Warren-SJ/Solar_Tracker/PCB/Top.png

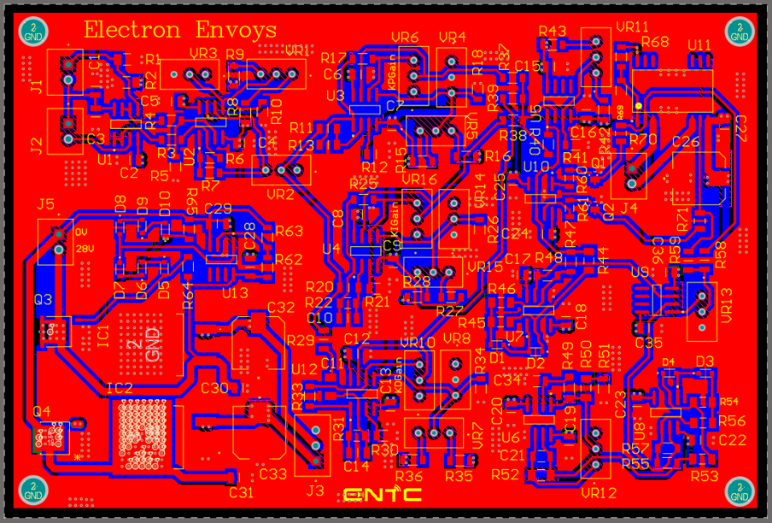
PCB/Top.png
