Warren-SJ/Solar_Tracker/PCB/Bottom.png

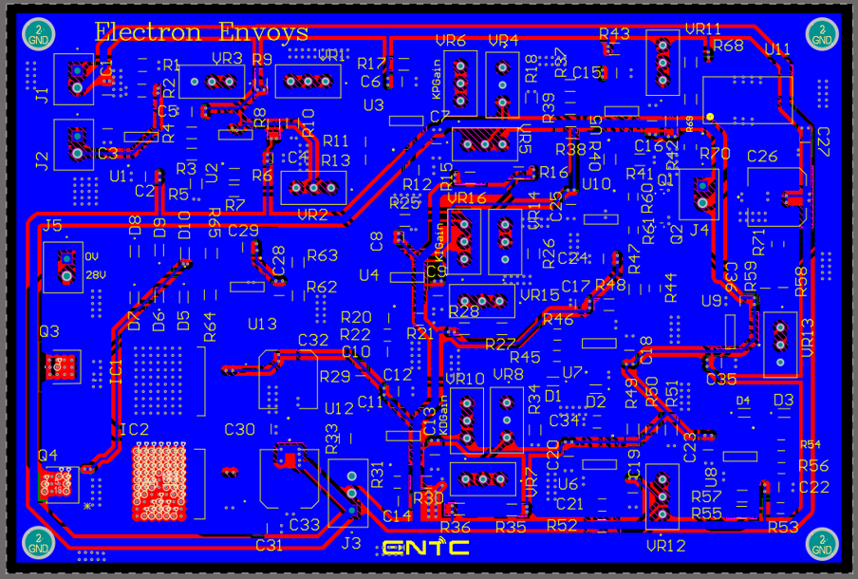
PCB/Bottom.png
