Warren-SJ/Solar_Tracker/README.md

# Solar_Tracker
An automated solar tracker made only using analog components
