Warren-SJ/Solar_Tracker/Enclosure/Enclosure.png

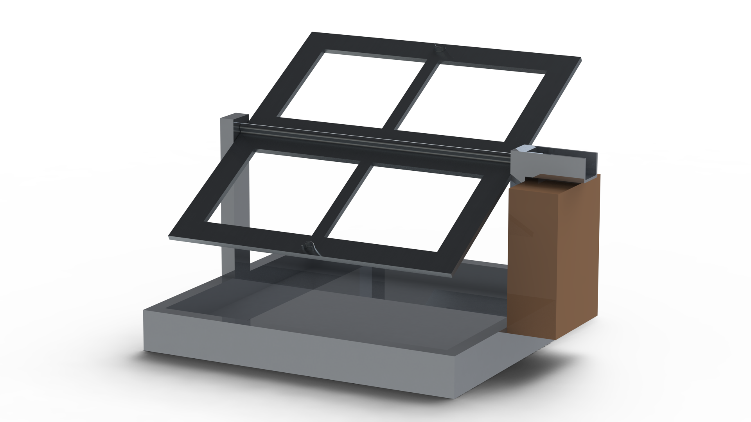
Enclosure/Enclosure.png
