Warren-SJ/Solar_Tracker/Enclosure/Assembly.STEP

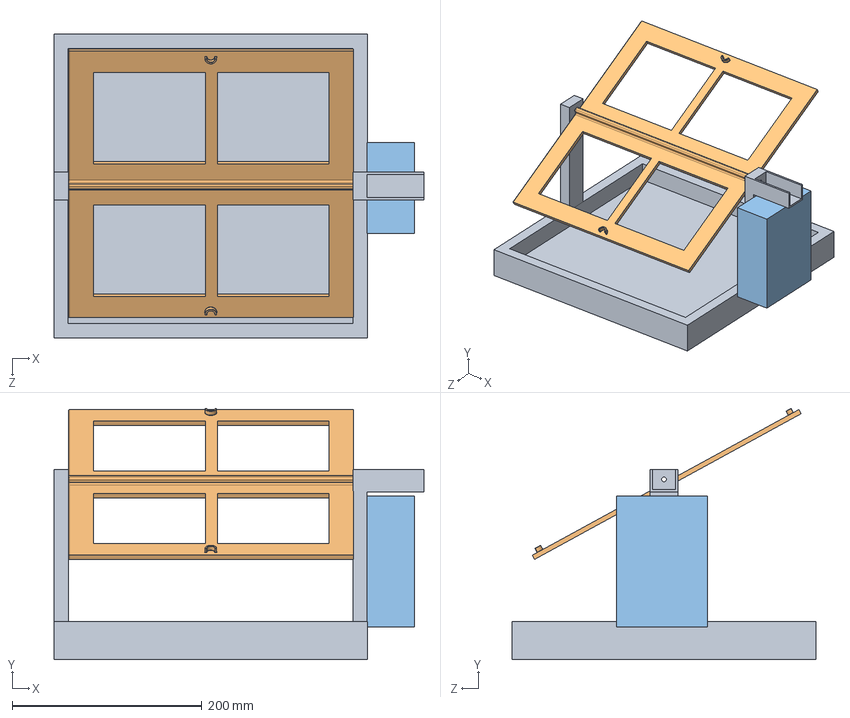
[picture p21: CAD file, 2024-01-17]
Enclosure/Assembly.STEP
389.7 x 264.5 x 320.0 mm
3D Body
Panel Holder
Enclodure
