Warren-SJ/Solar_Tracker/Enclosure/Base.STEP

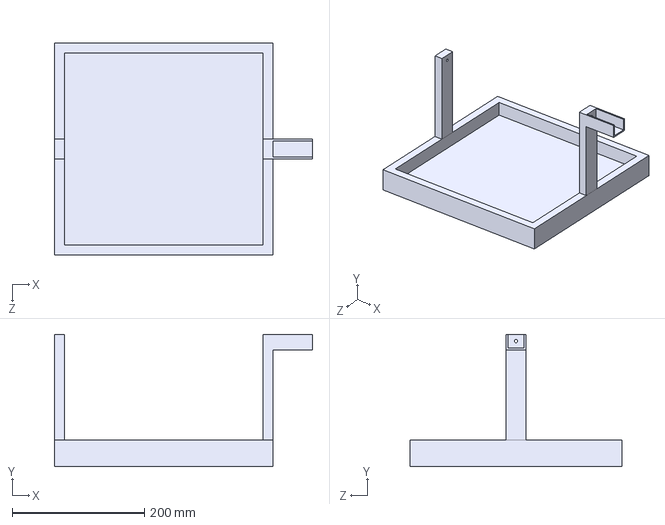
[picture p22: CAD file, 2024-01-17]
Enclosure/Base.STEP
389.7 x 200.0 x 320.0 mm
