Warren-SJ/Solar_Tracker/Enclosure/Panel Holder.STEP

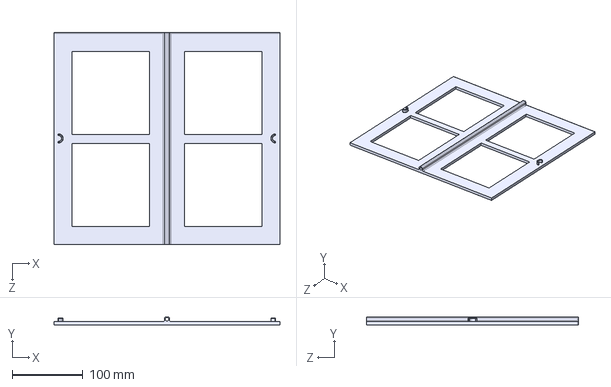
[picture p23: CAD file, 2024-01-17]
Enclosure/Panel Holder.STEP
320.0 x 12.0 x 300.0 mm
