Warren-SJ/Solar_Tracker/(list of files, cad)

Other CAD files:
Enclosure/Enclosure.DWG
