Warren-SJ/Solar_Tracker/(list of files, drawings)

Other design files:
PCB/Schematics_5.SchDoc
Simulation/Final Simulation.ms14
Simulation/First Simulation.ms14
