Warren-SJ/Solar_Tracker/(commit log)

2024-01-17 Added enclosure drawing and 3D models
    [Assembly.STEP, Base.STEP, Enclosure.DWG, Panel Holder.STEP]
2024-01-17 Added PCB design files
    [Schematics_5.SchDoc]
2024-01-17 Added PCB design images
2024-01-17 Added final simulation
    [Final Simulation.ms14]
2024-01-17 Added initial simulation
    [First Simulation.ms14]
2024-01-17 Added first simulation
    [First Simulation.ms14]
2024-02-19 Added new enclosure render
